eivholt/cough-monitor/README.md

# cough-monitor
Wearable cough monitor inpatients and remote patients using [Edge Impulse](https://studio.edgeimpulse.com/public/105885/latest).
