eivholt/cough-monitor/CAD/Clip-v1.stl

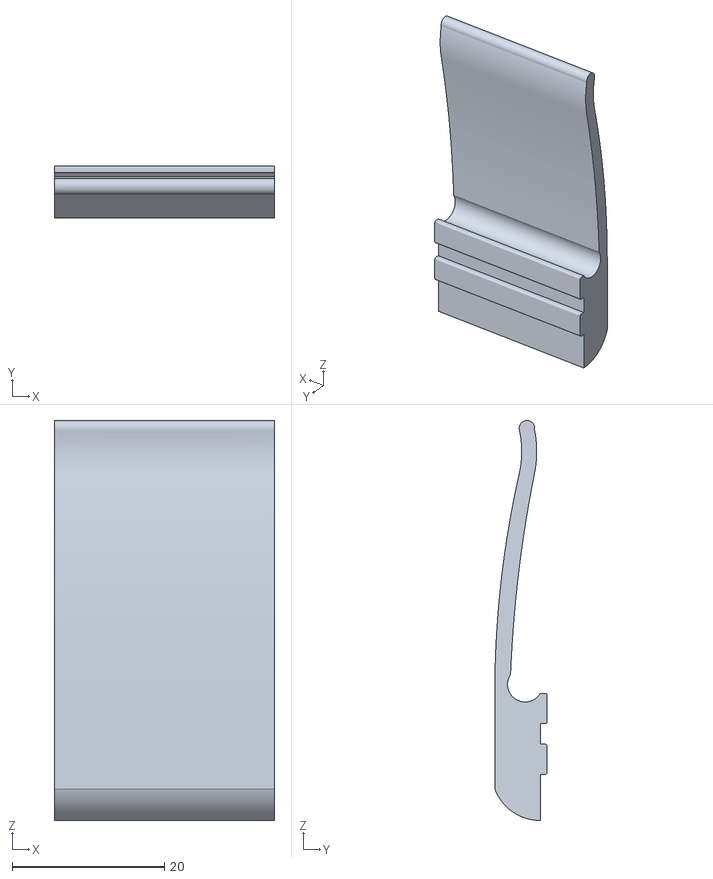
[picture p22: CAD file, 2022-11-08]
CAD/Clip-v1.stl
29.0 x 6.90 x 52.6
