eivholt/cough-monitor/CAD/Lid-v1.stl

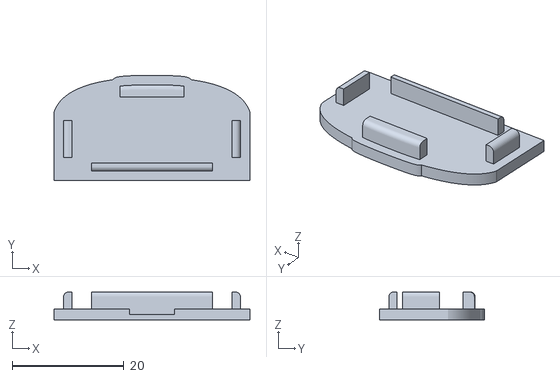
[picture p23: CAD file, 2022-11-08]
CAD/Lid-v1.stl
35.0 x 18.8 x 5.00
