eivholt/cough-monitor/CAD/Housing-v1.stl

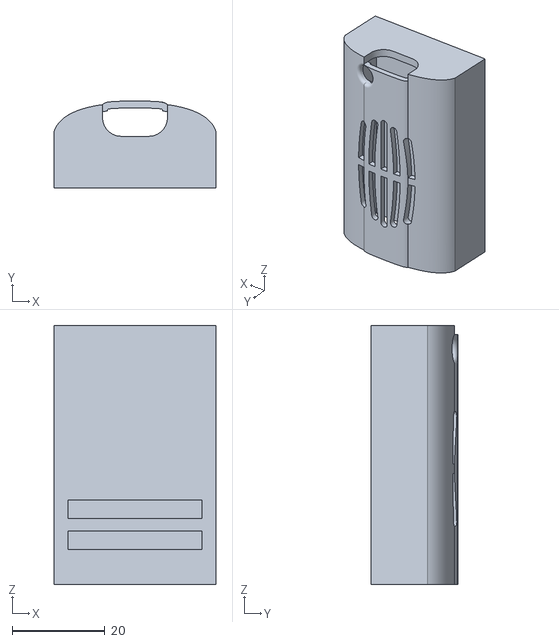
[picture p24: CAD file, 2022-11-08]
CAD/Housing-v1.stl
35.0 x 18.8 x 56.0
