eivholt/cough-monitor/arduino-nano/build.txt

arduino-cli compile -b arduino:mbed:nano33ble
